summoningdark/StereoLepton/(list of files, cad)

Other CAD files:
program_rom_v1.0.psm
program_rom_v2.0.psm
